RYJRGB/trekTaillight/hardware/pinAssignments.xlsx

TailLight Pin Assignments
Label | PIN | Type | Description | Notes
BRAKE_EN | PB0 | AF_PWM | Brake light enable pin. TIM3 Ch3 | PWM push pull
BACKUP_EN | PB1 | AF_PWM | Backup light enable pin. TIM3 Ch4 | PWM push pull
RED_EN | PB2 | GPIO OUT | 5050 RGB LED Red section
GRN_EN | PB10 | GPIO OUT | 5050 RGB LED Green section
BLU_EN | PB11 | GPIO OUT | 5050 RGB LED Blue section
VLED_EN | PB15 | GPIO OUT | VLED (48V supply enable pin) | DNP R13 and install R38 on PCB
EXT_SW_EN | PA6 | AF_PWM | EXT Switch TIM3 Ch1 (TURN EN) | Select R27 for VLED 48V (default) or Select R28 for 12V mode.
EXT_SW_CS | PA7 | GPIO IN | External load switch overcurrent sense (efuse future development) ignore for now
OSC_IN | PD0 | Clock IN
OSC_OUT | PD1 | Clock OUT
USB_DN | PA11 | USB DATA- | Disabled by default, unable to use at the same time with USB due to clock issues
USB_DP | PA12 | USB DATA+
CAN_RX | PB8 | CAN Received IN | Enabled by default
CAN_TX | PB9 | CAN Transmit OUT
