RYJRGB/trekTaillight/hardware/BoardPictures/back.PNG

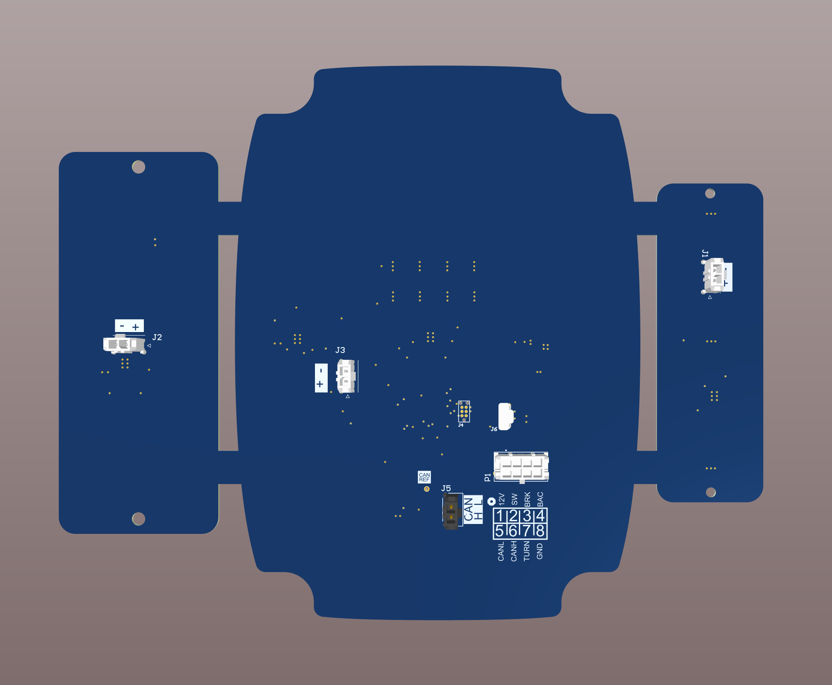
hardware/BoardPictures/back.PNG
