RYJRGB/trekTaillight/hardware/BoardPictures/front.PNG

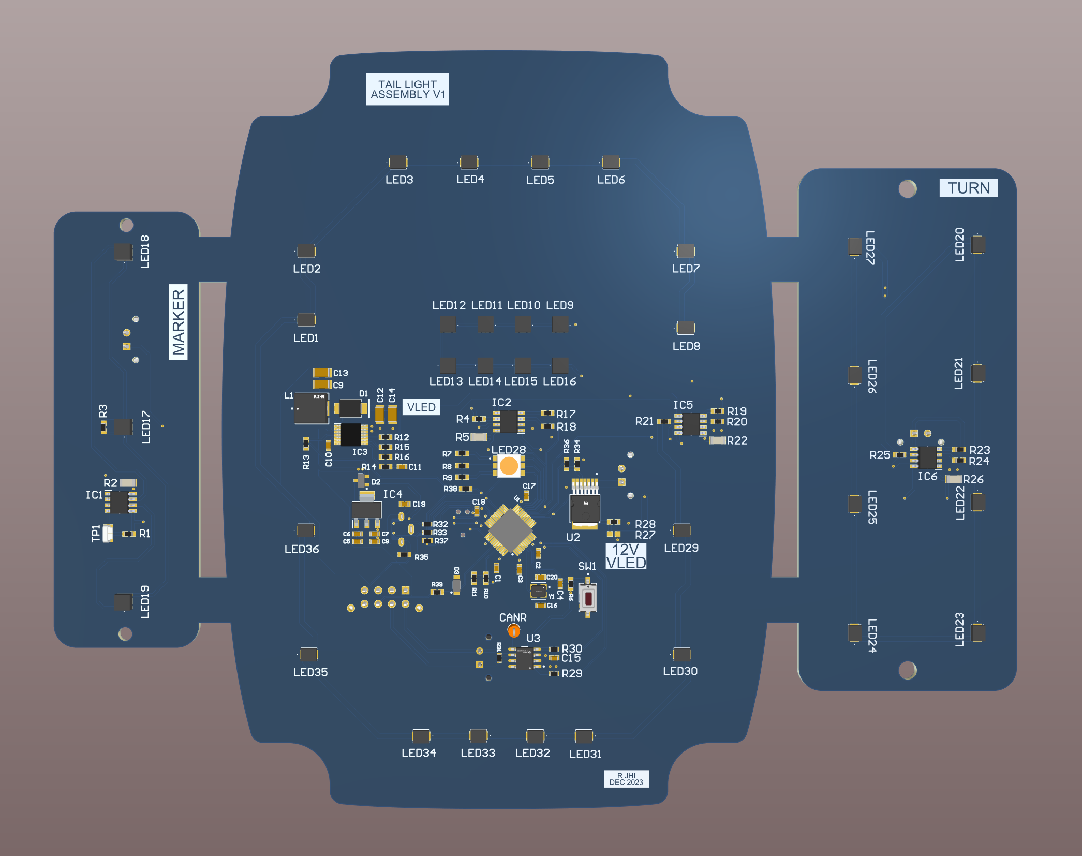
hardware/BoardPictures/front.PNG
