RYJRGB/trekTaillight/hardware/schematicSections/backup.PNG

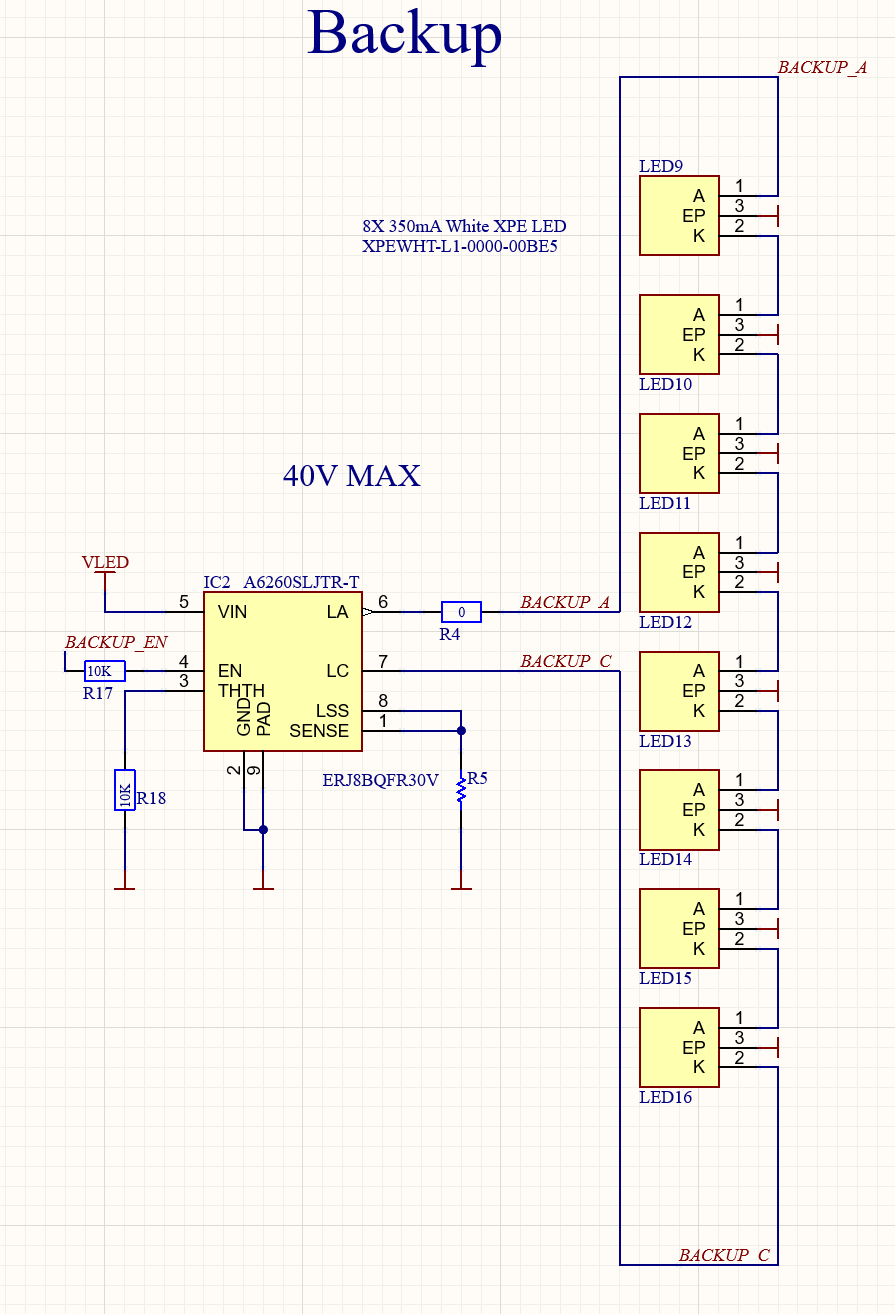
hardware/schematicSections/backup.PNG
