RYJRGB/trekTaillight/hardware/schematicSections/brake.PNG

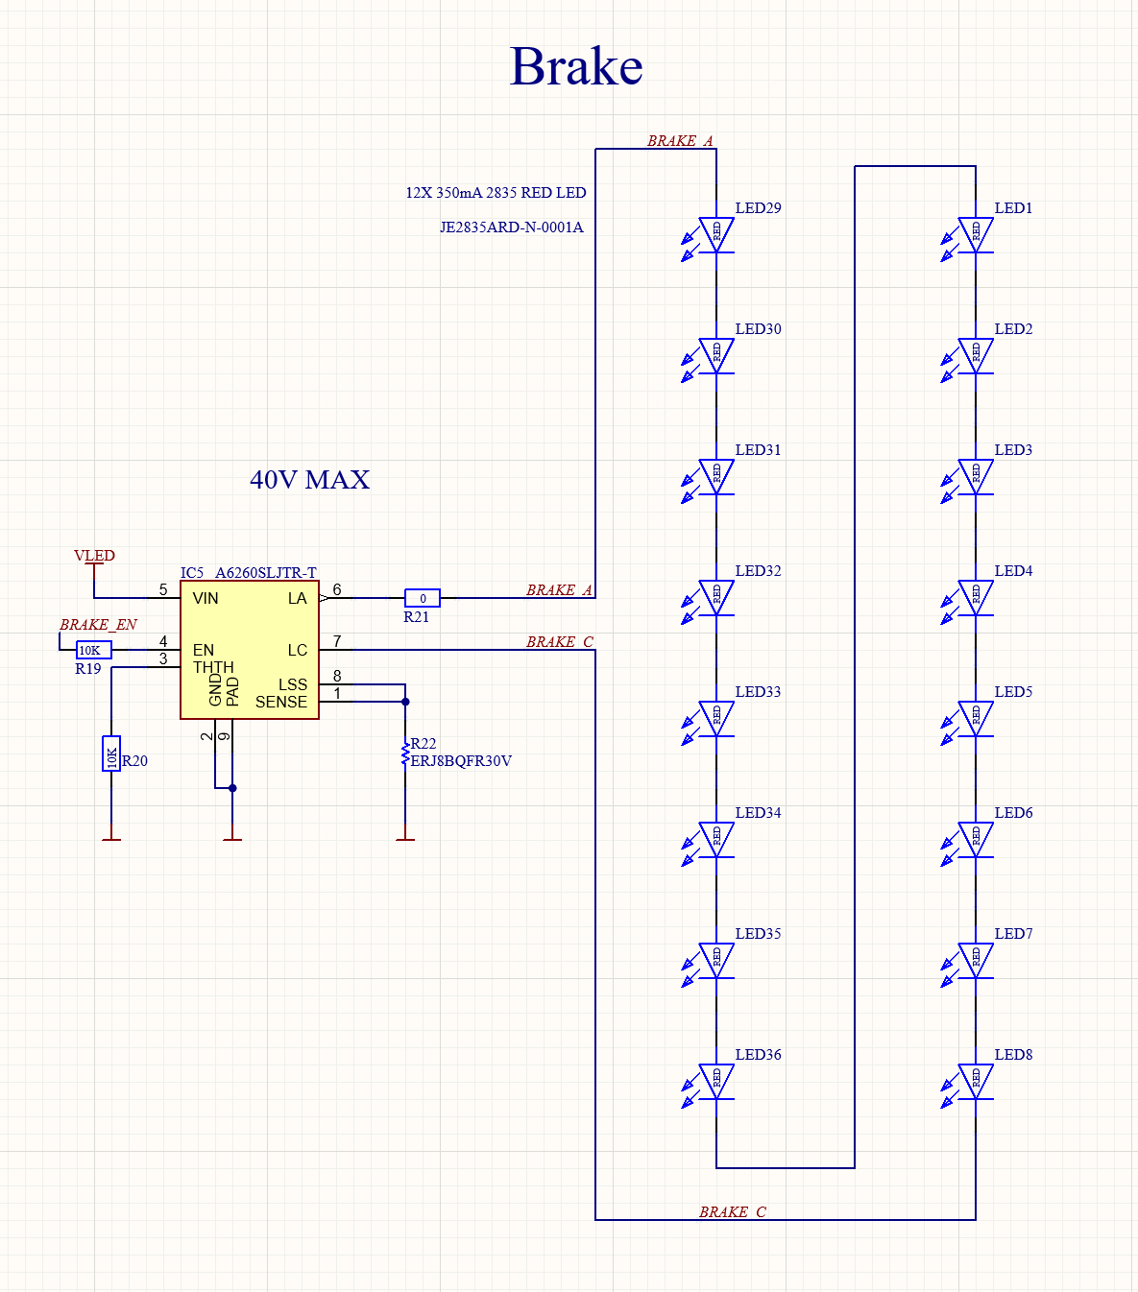
hardware/schematicSections/brake.PNG
