RYJRGB/trekTaillight/hardware/schematicSections/marker.PNG

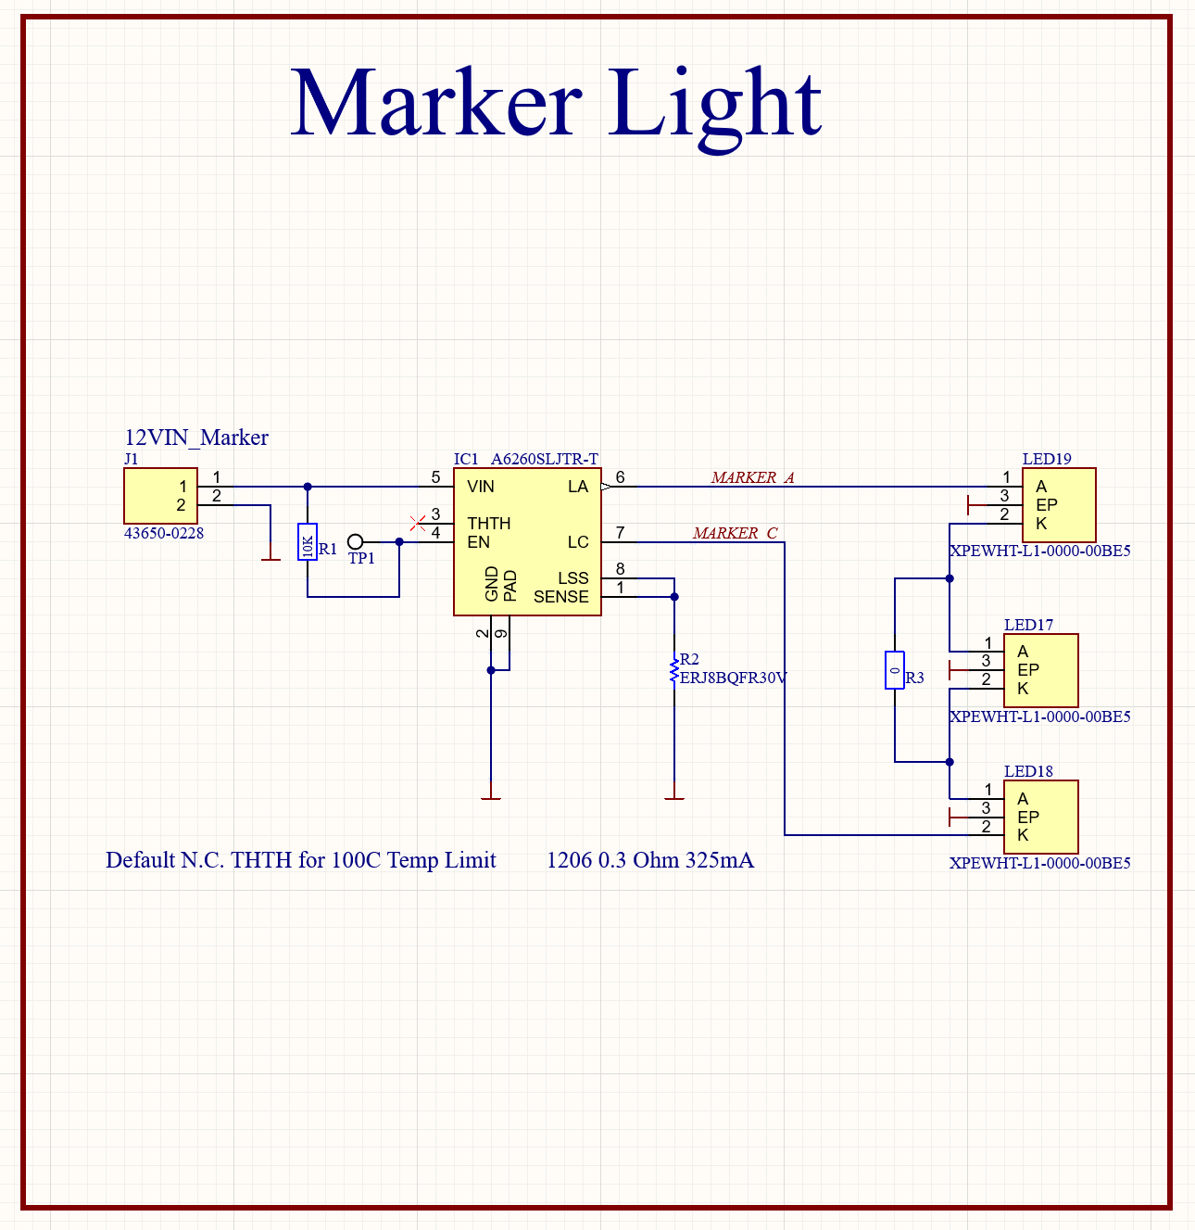
hardware/schematicSections/marker.PNG
