RYJRGB/trekTaillight/hardware/schematicSections/MCU.PNG

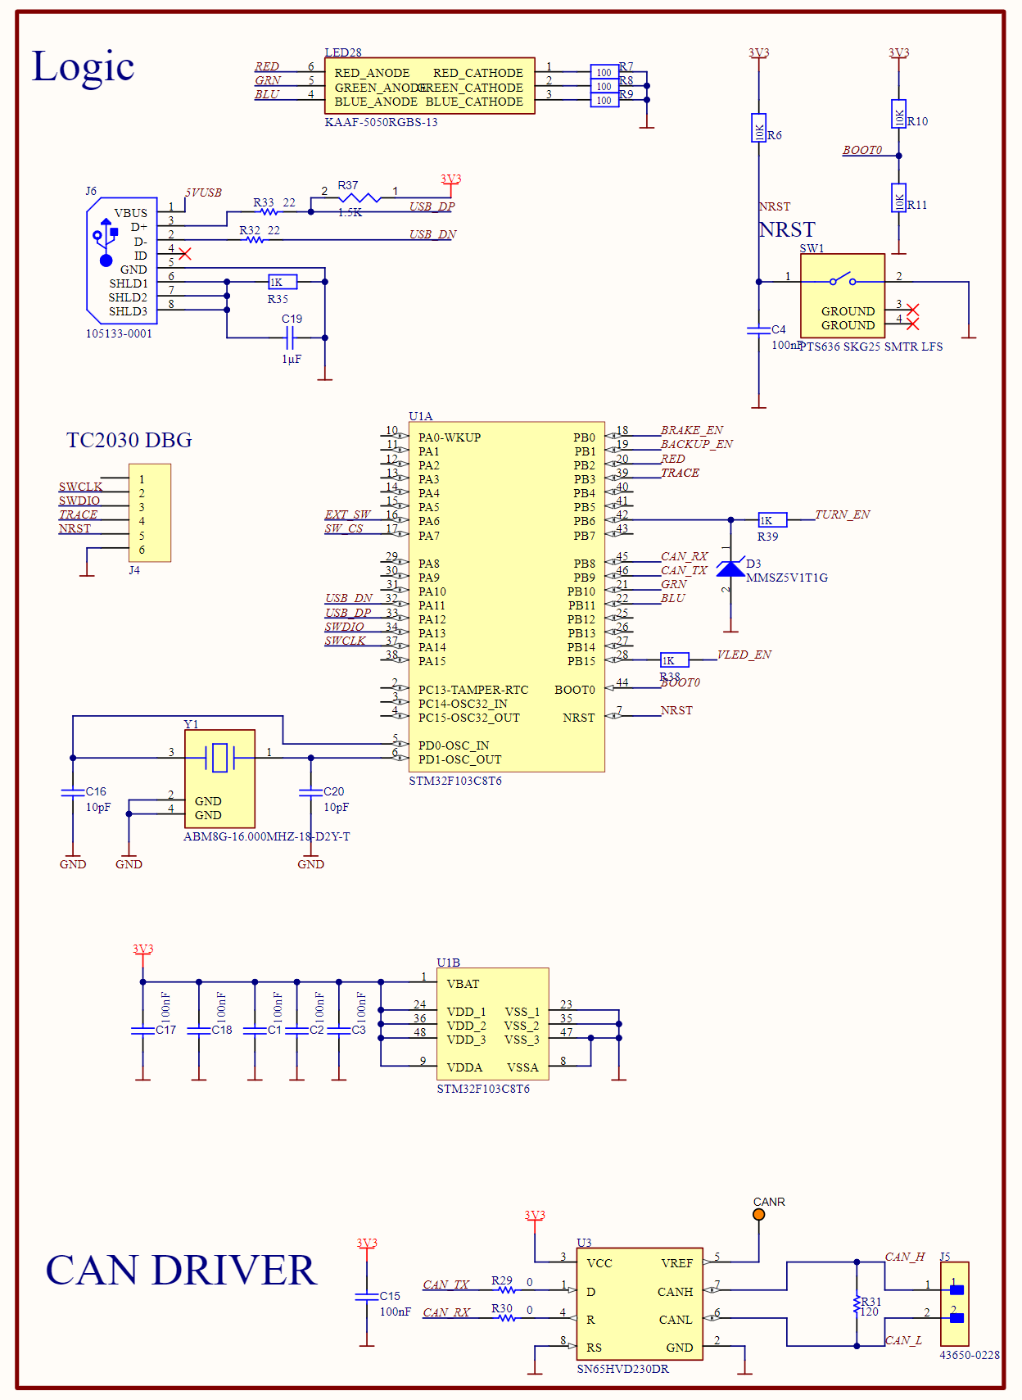
hardware/schematicSections/MCU.PNG
