RYJRGB/trekTaillight/hardware/schematicSections/power.PNG

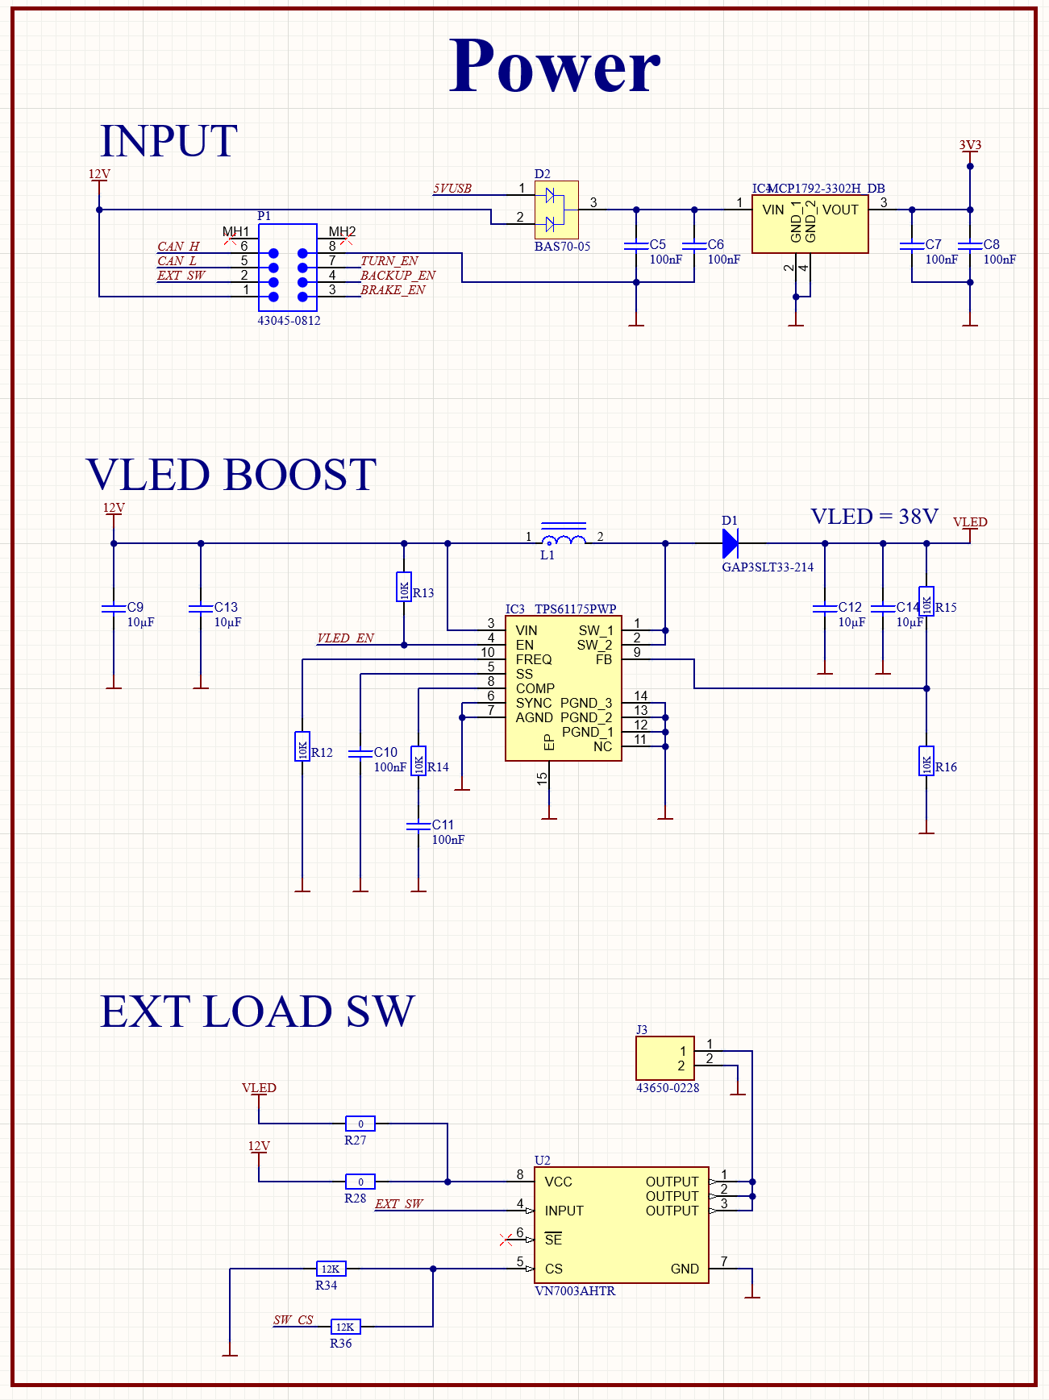
hardware/schematicSections/power.PNG
