RYJRGB/trekTaillight/hardware/schematicSections/turn.PNG

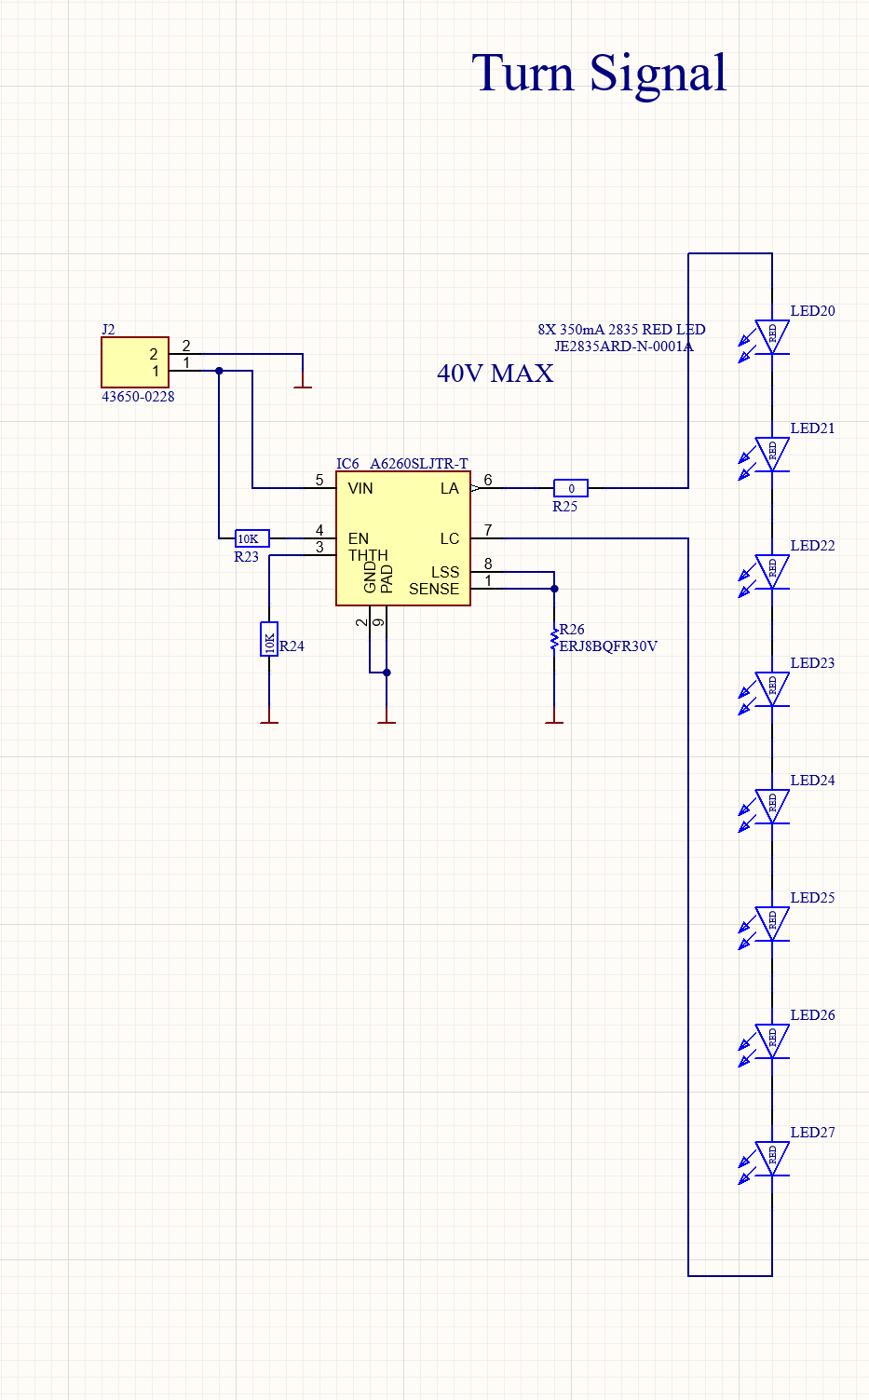
hardware/schematicSections/turn.PNG
