RYJRGB/trekTaillight/hardware/fullSchematic.pdf

# Turn Signal

Brake | RED

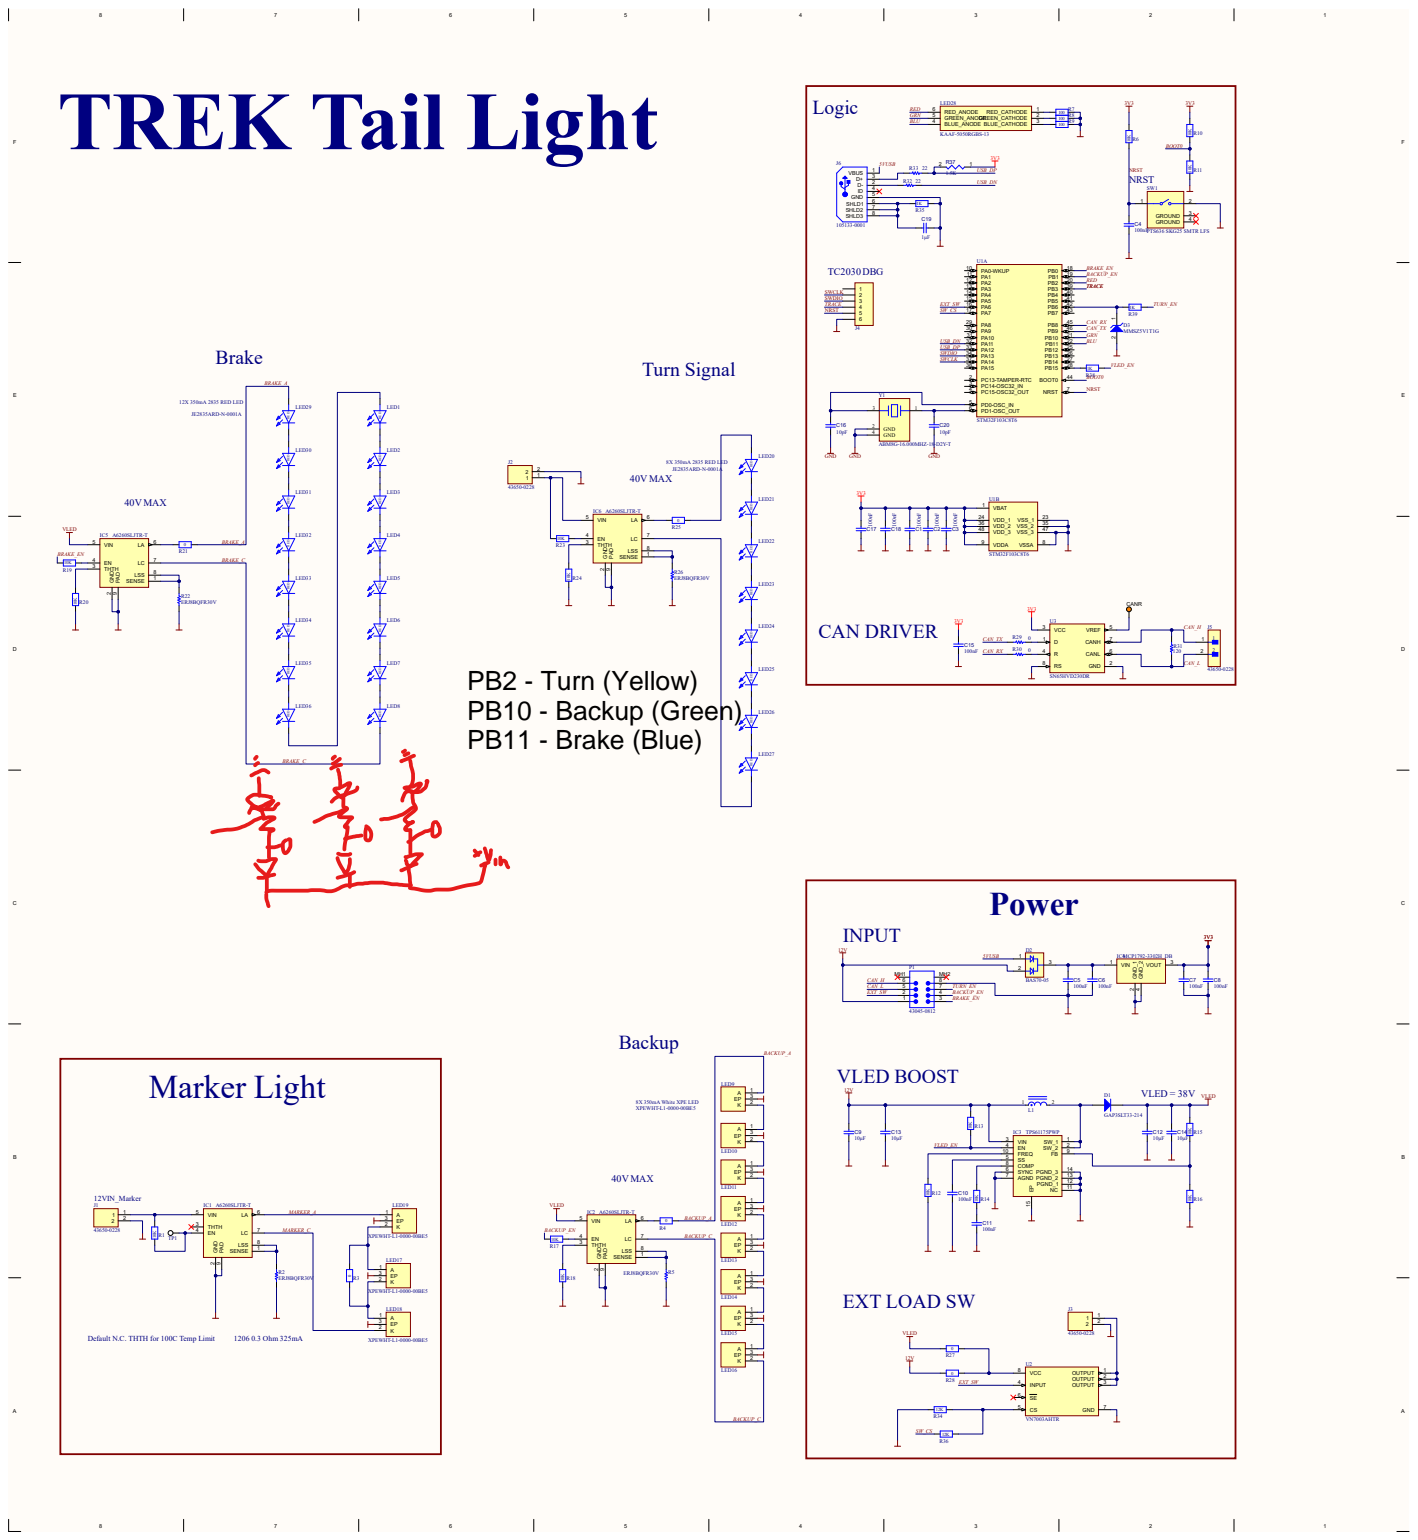
[picture p9: page 1]

Default N.C. THTH for 100C Temp Limit
