RYJRGB/trekTaillight/hardware/fullSchematicNotes.pdf

# Turn Signal

Brake | RED

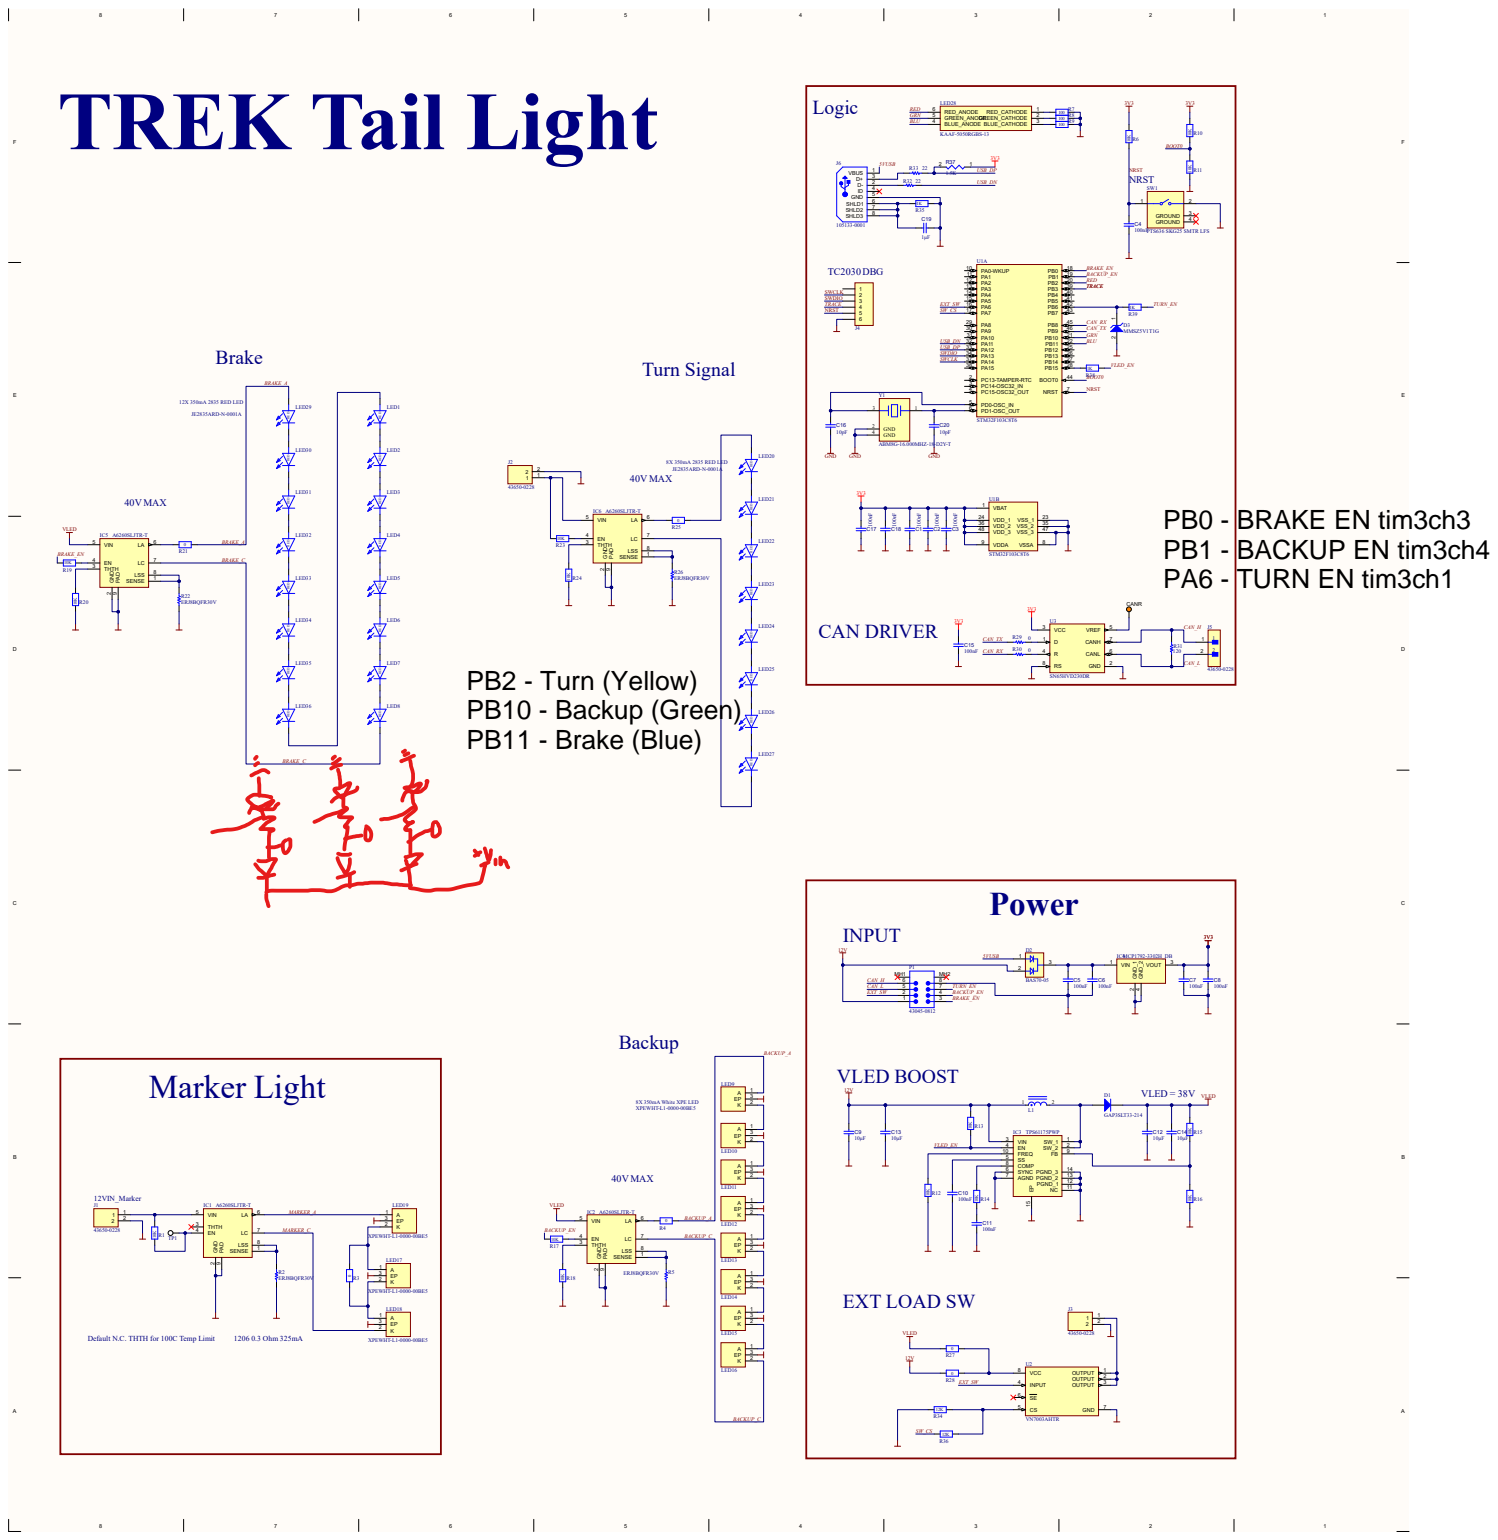
[picture p10: page 1]

Default N.C. THTH for 100C Temp Limit
