RYJRGB/trekTaillight/hardware/schematicSections/fullSchematic.pdf

# Turn Signal

Brake | RED

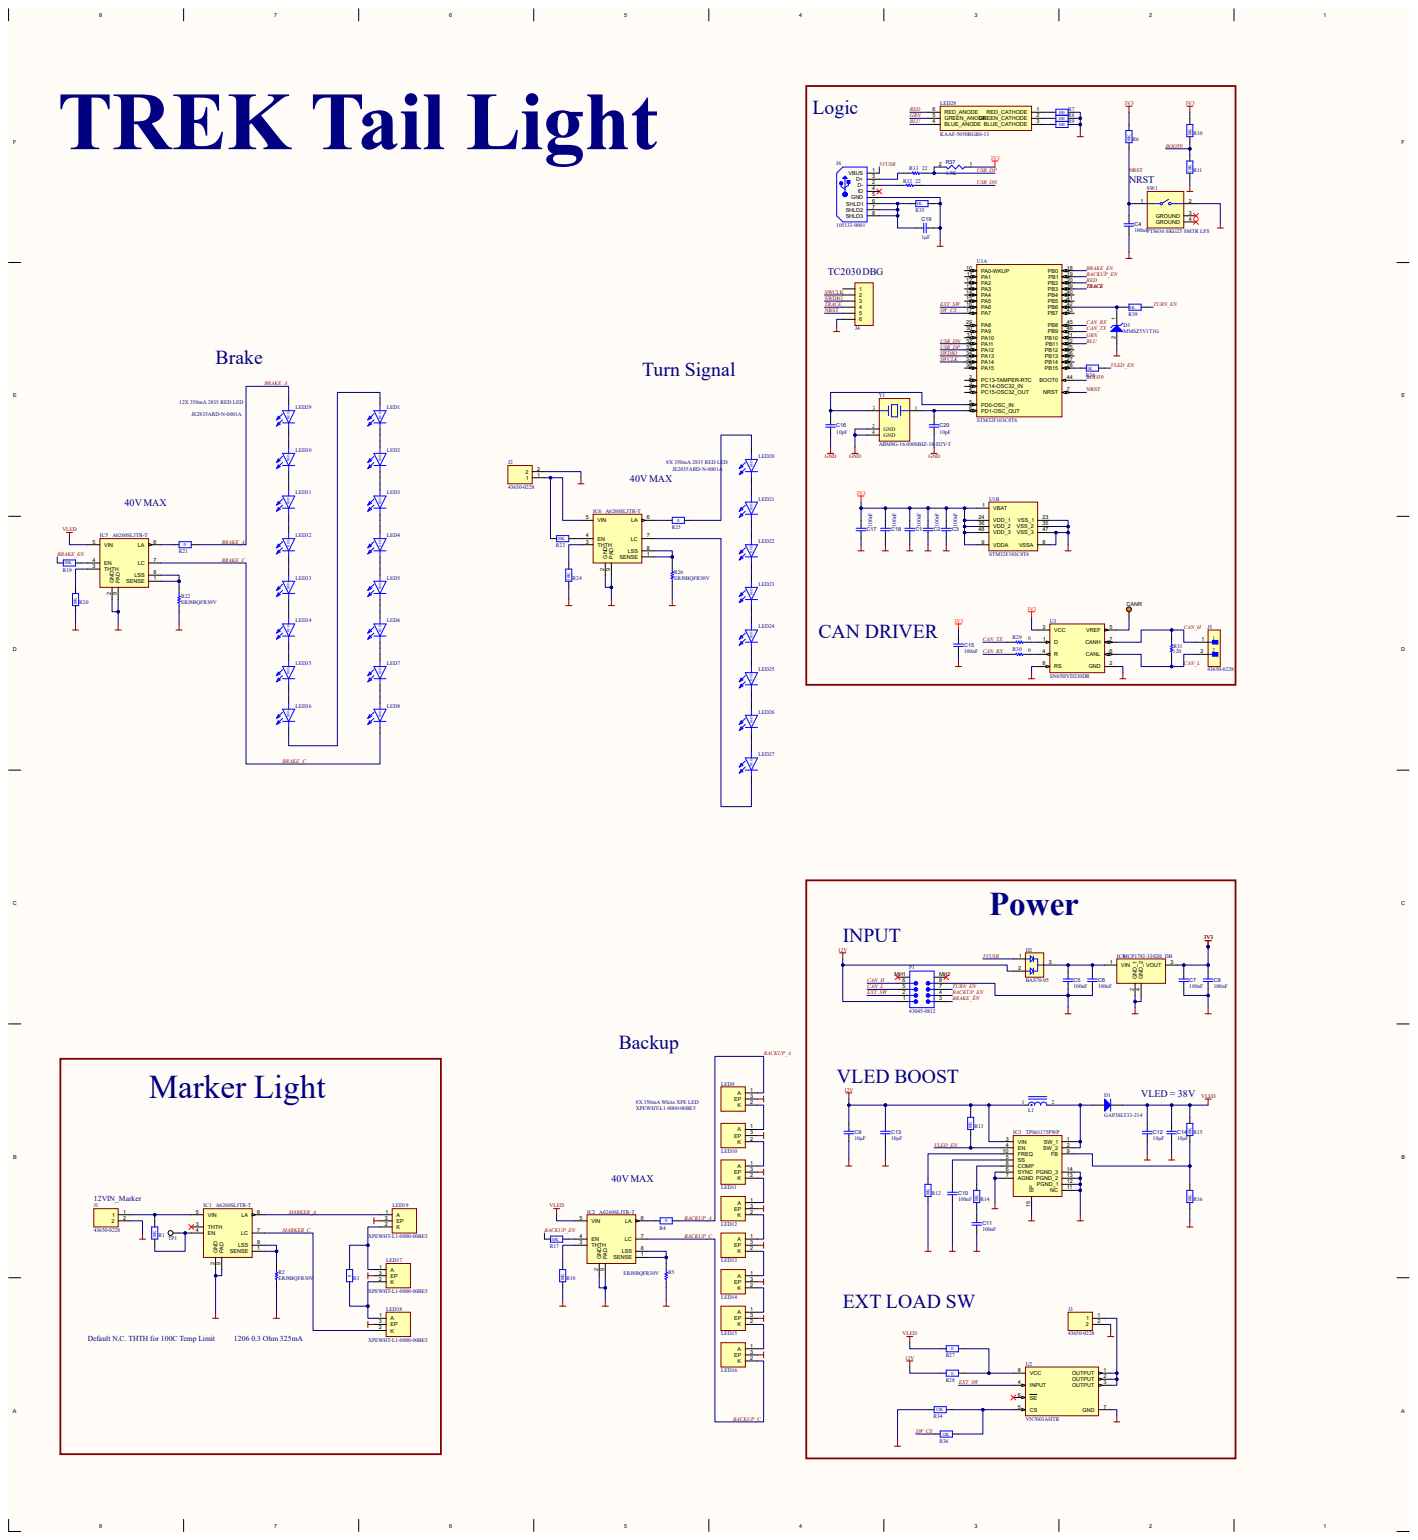
[picture p11: page 1]

Default N.C. THTH for 100C Temp Limit
