RYJRGB/trekTaillight/(list of files, drawings)

Other design files:
hardware/Gerbers/tailLight.PrjPcb
hardware/Gerbers/tailLite.SchDoc
