RYJRGB/trekTaillight/firmware/Core/Src/main.c

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
/* Includes ------------------------------------------------------------------*/
#include "main.h"

TIM_HandleTypeDef htim3;

/* USER CODE BEGIN PV */
#define BRAKE_BRIGHTNESS 5
#define BACKUP_BRIGHTNESS 5
#define TURN_BRIGHTNESS 5
/* USER CODE END PV */

void SystemClock_Config(void);
static void MX_GPIO_Init(void);
static void MX_TIM3_Init(void);
/* USER CODE BEGIN PFP */
void Start_PWM(void);
void checkLEDState(void);
/* USER CODE END PFP */

/**
  * @brief  The application entry point.
  * @retval int
  */
int main(void)
{
  /* MCU Configuration--------------------------------------------------------*/

  /* Reset of all peripherals, Initializes the Flash interface and the Systick. */
  HAL_Init();

  /* Configure the system clock */
  SystemClock_Config();

  /* Initialize all configured peripherals */
  MX_GPIO_Init();
  MX_TIM3_Init();
  /* USER CODE BEGIN 2 */
  HAL_Delay(10);
  HAL_GPIO_WritePin(VLED_EN_GPIO_Port, VLED_EN_Pin, SET); //toggle VLED enable PB15
  HAL_Delay(10);
  Start_PWM();

  /* USER CODE END 2 */

  /* Infinite loop */
  /* USER CODE BEGIN WHILE */
  while (1)
  {

	  HAL_Delay(50);
	  checkLEDState();

	  //HAL_GPIO_TogglePin(RED_LED_GPIO_Port, RED_LED_Pin); //on board red LED PC13
//	  HAL_GPIO_WritePin(RED_LED_GPIO_Port, RED_LED_Pin, RESET);
//	  HAL_GPIO_WritePin(VLED_EN_GPIO_Port, VLED_EN_Pin, RESET); //toggle Brake PB0
//	  HAL_GPIO_WritePin(BRAKE_EN_GPIO_Port, BRAKE_EN_Pin, RESET); //toggle Brake PB1
//	  HAL_Delay(100);
//	  HAL_GPIO_WritePin(RED_LED_GPIO_Port, RED_LED_Pin, SET); //on board red LED PC13
//	  HAL_GPIO_WritePin(BRAKE_EN_GPIO_Port, BRAKE_EN_Pin, SET); //toggle Brake PB0
//	  HAL_GPIO_WritePin(BACKUP_EN_GPIO_Port, BACKUP_EN_Pin, SET); //toggle Brake PB1
//	  HAL_Delay(100);
    /* USER CODE END WHILE */

    /* USER CODE BEGIN 3 */
  }
  /* USER CODE END 3 */
}

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
/* USER CODE BEGIN 4 */
void checkLEDState(void){
	if(HAL_GPIO_ReadPin(BLUE_GPIO_Port, BLUE_Pin)){ //if brake (BLUE) line is activated:
		//__HAL_TIM_SET_COMPARE(&htim3, TIM_CHANNEL_3, BRAKE_BRIGHTNESS);
		HAL_GPIO_WritePin(BRAKE_EN_GPIO_Port, BRAKE_EN_Pin, SET);
	}
	else{
		HAL_GPIO_WritePin(BRAKE_EN_GPIO_Port, BRAKE_EN_Pin, RESET);
		//__HAL_TIM_SET_COMPARE(&htim3, TIM_CHANNEL_3, 0);
	}

	if(HAL_GPIO_ReadPin(GREEN_GPIO_Port, GREEN_Pin)){ //if backup (GREEN) line is activated:
		__HAL_TIM_SET_COMPARE(&htim3, TIM_CHANNEL_4, BACKUP_BRIGHTNESS);
	}
	else{
		__HAL_TIM_SET_COMPARE(&htim3, TIM_CHANNEL_4, 0);
	}

	if(HAL_GPIO_ReadPin(YELLOW_GPIO_Port, YELLOW_Pin)){ //if turn (YELLOW) line is activated:
		__HAL_TIM_SET_COMPARE(&htim3, TIM_CHANNEL_1, TURN_BRIGHTNESS);
	}
	else{
		__HAL_TIM_SET_COMPARE(&htim3, TIM_CHANNEL_1, 0);
	}
}

void Start_PWM(void)
{
    HAL_TIM_PWM_Start(&htim3, TIM_CHANNEL_1);  // Start PWM for EXT_SW_EN
    //HAL_TIM_PWM_Start(&htim3, TIM_CHANNEL_3);  // Start PWM for BRAKE_EN
    HAL_TIM_PWM_Start(&htim3, TIM_CHANNEL_4);  // Start PWM for BACKUP_EN
}
/* USER CODE END 4 */
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
