RYJRGB/trekTaillight/firmware/Core/Inc/main.h

#define RED_LED_Pin GPIO_PIN_13
#define RED_LED_GPIO_Port GPIOC
#define EXT_SW_EN_Pin GPIO_PIN_6
#define EXT_SW_EN_GPIO_Port GPIOA
#define EXT_SW_CS_Pin GPIO_PIN_7
#define EXT_SW_CS_GPIO_Port GPIOA
#define BRAKE_EN_Pin GPIO_PIN_0
#define BRAKE_EN_GPIO_Port GPIOB
#define BACKUP_EN_Pin GPIO_PIN_1
#define BACKUP_EN_GPIO_Port GPIOB
#define YELLOW_Pin GPIO_PIN_2
#define YELLOW_GPIO_Port GPIOB
#define GREEN_Pin GPIO_PIN_10
#define GREEN_GPIO_Port GPIOB
#define BLUE_Pin GPIO_PIN_11
#define BLUE_GPIO_Port GPIOB
#define VLED_EN_Pin GPIO_PIN_15
#define VLED_EN_GPIO_Port GPIOB
#define EXT_TURN_IN_Pin GPIO_PIN_6
#define EXT_TURN_IN_GPIO_Port GPIOB
