RYJRGB/trekTaillight/(commit log)

2024-02-24 code generated
    [pinAssignments.xlsx]
2024-10-28 Added finished board pics
    [BOM.csv, pinAssignments.xlsx]
2024-10-28 changed GPIO for LEDs to PWM
2024-10-30 BASIC lighting functions no CAN
    [pinAssignments.xlsx]
