RYJRGB/trekTaillight/(notices)

Notices in the files:
firmware/Core/Inc/main.h:
Copyright (c) 2024 STMicroelectronics.
All rights reserved.
This software is licensed under terms that can be found in the LICENSE file
